jingwei55/CG2111A-Final-Project/README.md

# CG2111A-Final-Project
Code for CG2111A module's final project
